kelu124/DAC2932/viewme.png

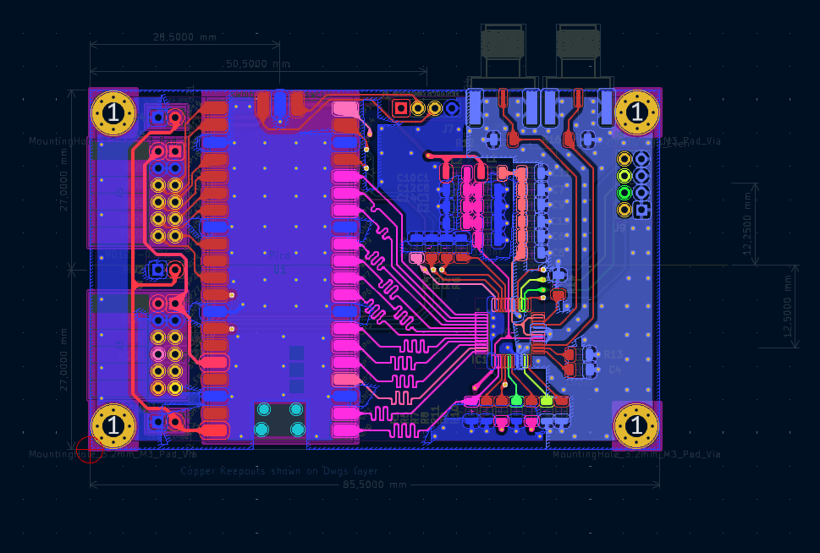
viewme.png
