kelu124/DAC2932/schematics.pdf

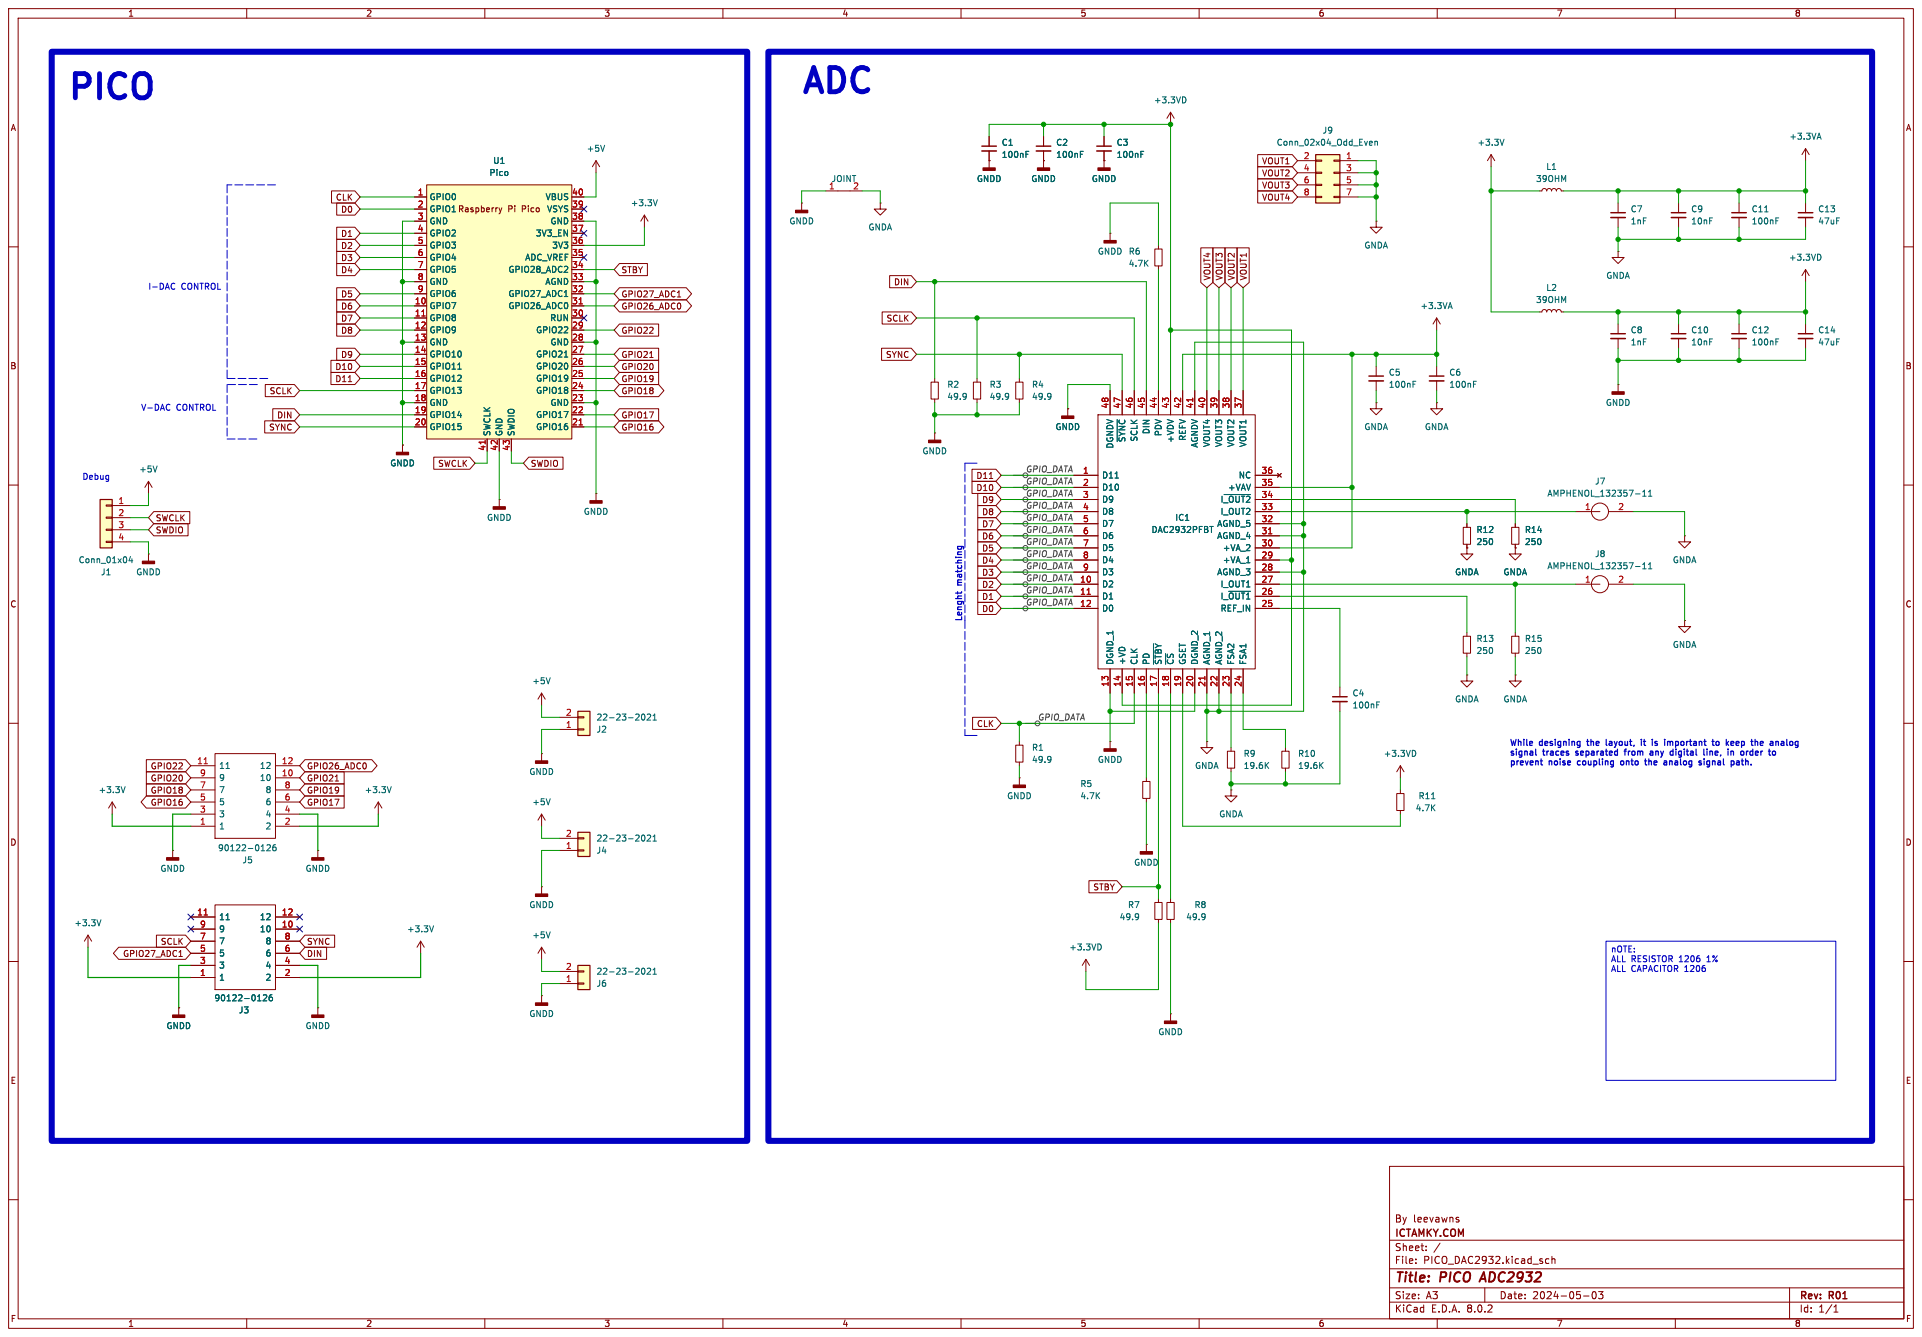
[picture p3: page 1]

I-DAC CONTROL V-DAC CONTROL PICO

While designing the layout, it is important to keep the analog
signal traces separated from any digital line, in order to
prevent noise coupling onto the analog signal path. nOTE: ALL RESISTOR 1206 1%
