kelu124/DAC2932/hardware/PICO_DAC2932.kicad_pcb

## KiCad design hardware/PICO_DAC2932.kicad_pcb (2024-09-25)

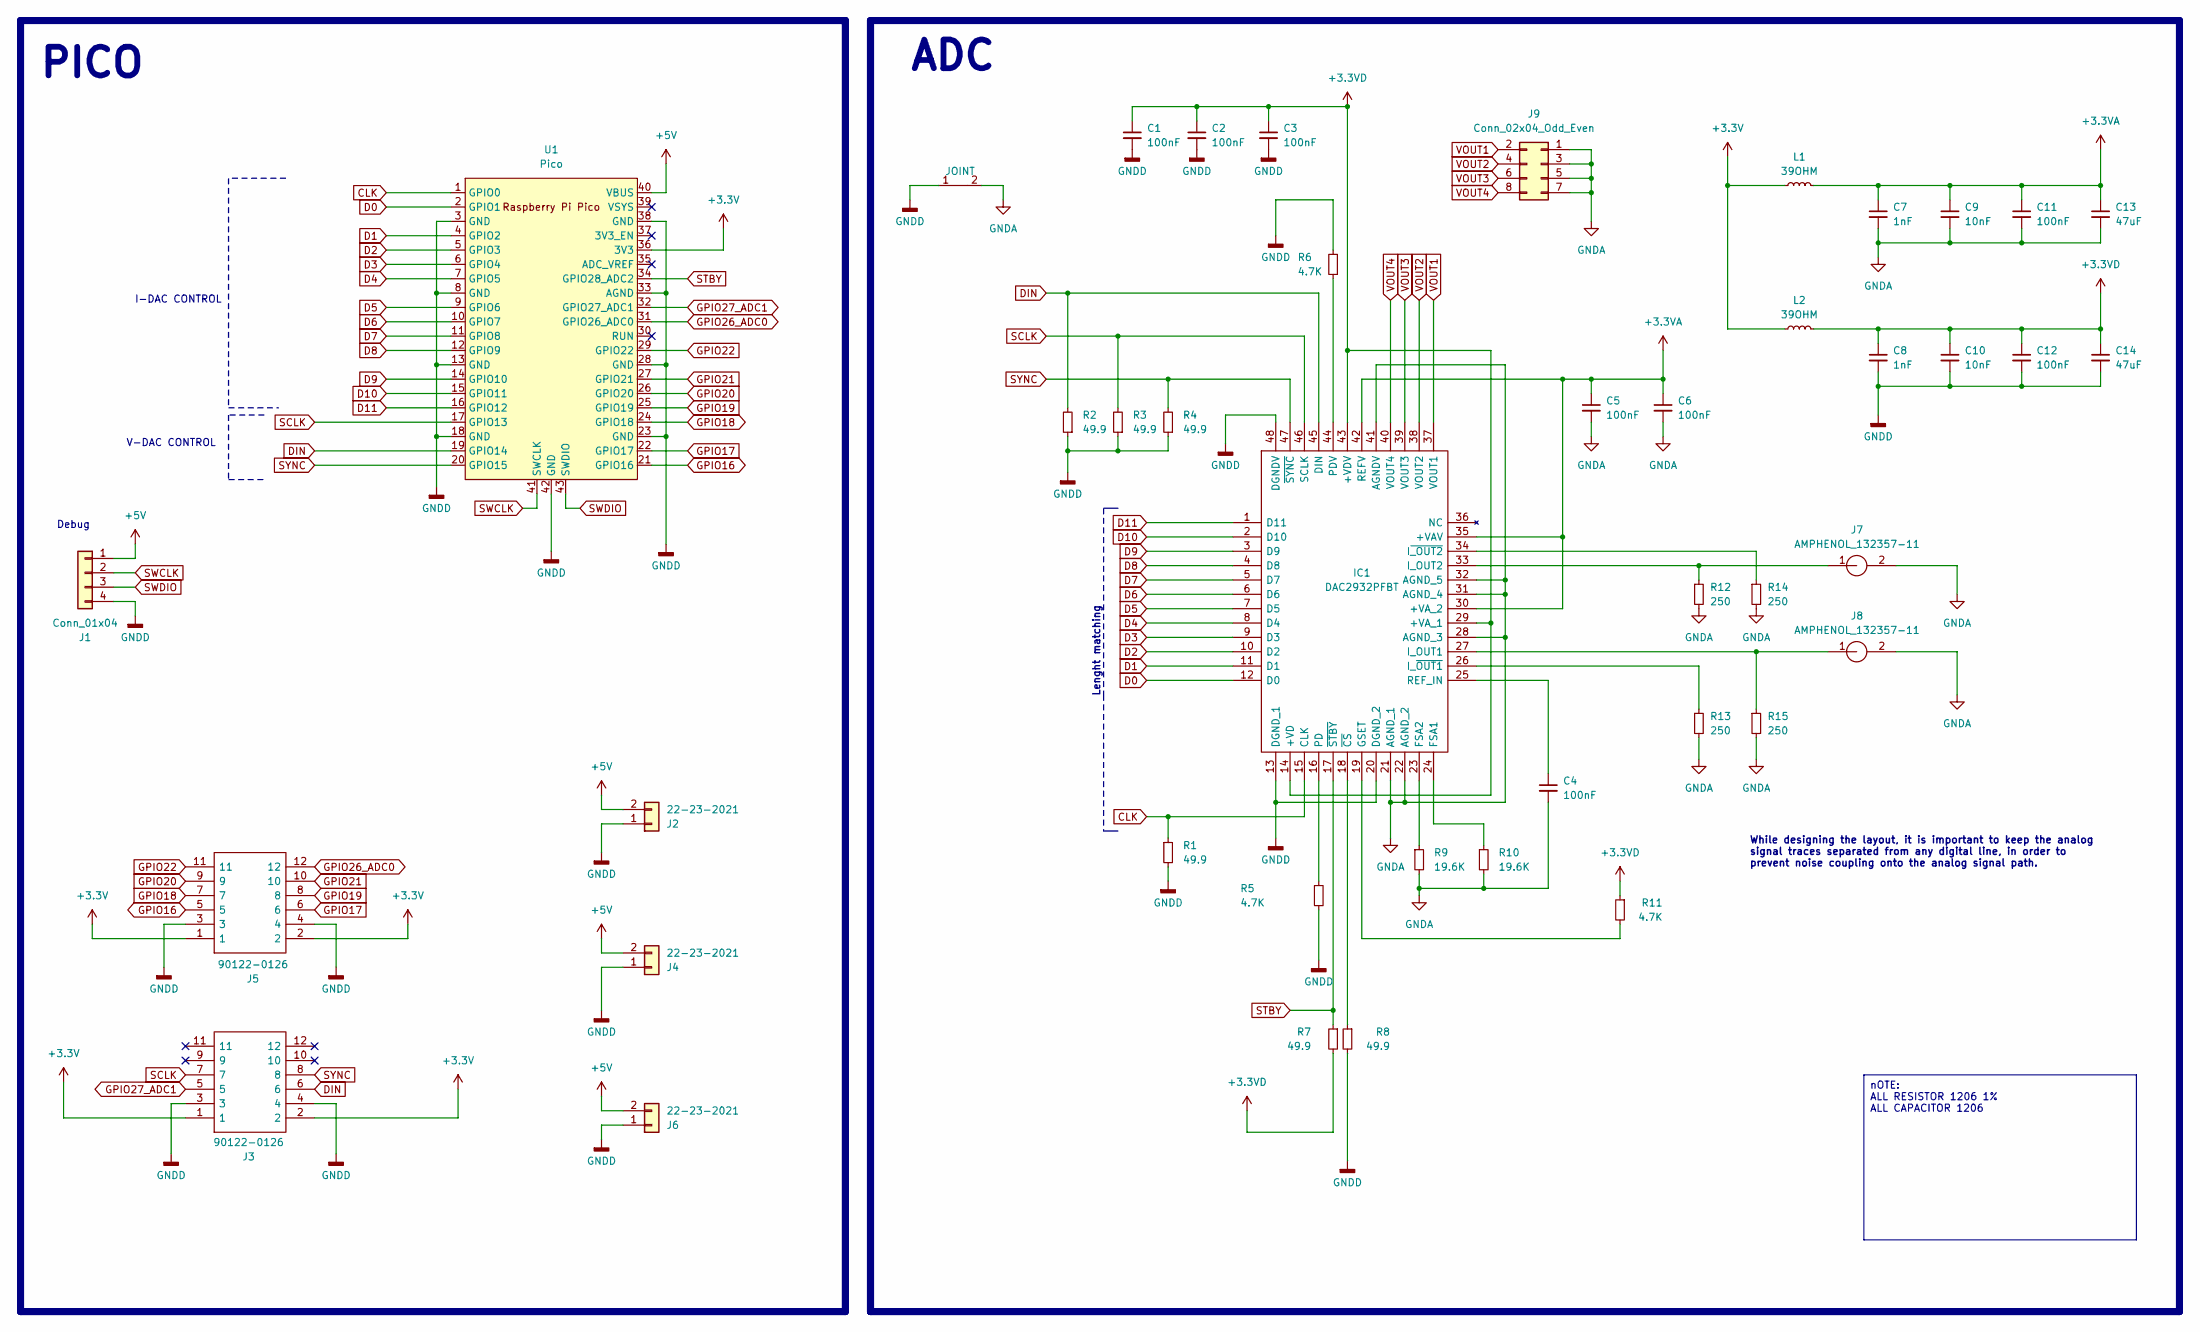
[picture p4: schematic PICO_DAC2932.kicad_sch, PICO ADC2932]

Parts:
C1, C2, C3, C4, C5, C6, C11, C12: 100nF; C_1206_3216Metric
C7, C8: 1nF; C_1206_3216Metric
C9, C10: 10nF; C_1206_3216Metric
C13, C14: 47uF; C_1206_3216Metric
IC1: DAC2932PFBT; QFP50P900X900X120-48N; Mouser Part Number 595-DAC2932PFBT
J1: Conn_01x04; PinHeader_1x04_P2.54mm_Vertical
J2, J4, J6: 22-23-2021; PinHeader_1x02_P2.54mm_Vertical; MPN 22-23-2021
J3, J5: 90122-0126; PinSocket_2x06_P2.54mm_Horizontal; Mouser Part Number 710-613012243121
J7, J8: AMPHENOL_132357-11; Mouser Part Number 530-142-0701-801
J9: Conn_02x04_Odd_Even; PinHeader_2x04_P2.54mm_Vertical
JO1: JOINT
L1, L2: 39OHM; L_1206_3216Metric; Tolerance 1%
R1, R2, R3, R4, R7, R8: 49.9; R_1206_3216Metric; Tolerance 1%
R5, R6, R11: 4.7K; R_1206_3216Metric; Tolerance 1%
R9, R10: 19.6K; R_1206_3216Metric; Tolerance 1%
R12, R13, R14, R15: 250; R_1206_3216Metric; Tolerance 1%
U1: Pico; RPi_Pico_SMD; MPN Pico

Connections:
+3.3V: J3.1, J3.2, J5.1, J5.2, L1.1, L2.1, U1.36 (3V3)
+3.3VA: C5.1, C6.1, C7.1, C9.1, C11.1, C13.1, IC1.30 (+VA_2), IC1.35 (+VAV), IC1.42 (REFV), L1.2
+3.3VD: C1.1, C2.1, C3.1, C8.1, C10.1, C12.1, C14.1, IC1.14 (+VD), IC1.29 (+VA_1), IC1.43 (+VDV), L2.2, R7.2, R11.1
+5V: J1.1, J2.2, J4.2, J6.2, U1.40 (VBUS)
CLK: IC1.15 (CLK), R1.1, U1.1 (GPIO0)
D0: IC1.12 (D0), U1.2 (GPIO1)
D1: IC1.11 (D1), U1.4 (GPIO2)
D2: IC1.10 (D2), U1.5 (GPIO3)
D3: IC1.9 (D3), U1.6 (GPIO4)
D4: IC1.8 (D4), U1.7 (GPIO5)
D5: IC1.7 (D5), U1.9 (GPIO6)
D6: IC1.6 (D6), U1.10 (GPIO7)
D7: IC1.5 (D7), U1.11 (GPIO8)
D8: IC1.4 (D8), U1.12 (GPIO9)
D9: IC1.3 (D9), U1.14 (GPIO10)
D10: IC1.2 (D10), U1.15 (GPIO11)
D11: IC1.1 (D11), U1.16 (GPIO12)
DIN: IC1.45 (DIN), J3.6, R2.2, U1.19 (GPIO14)
GNDA: C4.2, C5.2, C6.2, C7.2, C9.2, C11.2, C13.2, IC1.21 (AGND_1), IC1.22 (AGND_2), IC1.28 (AGND_3), IC1.31 (AGND_4), IC1.32 (AGND_5), IC1.41 (AGNDV), J7.2, J8.2, J9.1, J9.3, J9.5, J9.7, JO1.2, R9.2, R10.2, R12.2, R13.2, R14.2, R15.2
GNDD: C1.2, C2.2, C3.2, C8.2, C10.2, C12.2, C14.2, IC1.13 (DGND_1), IC1.20 (DGND_2), IC1.48 (DGNDV), J1.4, J2.1, J3.3, J3.4, J4.1, J5.3, J5.4, J6.1, JO1.1, R1.2, R2.1, R3.1, R4.1, R5.2, R6.2, R8.2, U1.3 (GND), U1.8 (GND), U1.13 (GND), U1.18 (GND), U1.23 (GND), U1.28 (GND), U1.33 (AGND), U1.38 (GND), U1.42 (GND)
GPIO16: J5.5, U1.21 (GPIO16)
GPIO17: J5.6, U1.22 (GPIO17)
GPIO18: J5.7, U1.24 (GPIO18)
GPIO19: J5.8, U1.25 (GPIO19)
GPIO20: J5.9, U1.26 (GPIO20)
GPIO21: J5.10, U1.27 (GPIO21)
GPIO22: J5.11, U1.29 (GPIO22)
GPIO26_ADC0: J5.12, U1.31 (GPIO26_ADC0)
GPIO27_ADC1: J3.5, U1.32 (GPIO27_ADC1)
unnamed: IC1.24 (FSA1), R10.1
unnamed: IC1.23 (FSA2), R9.1
unnamed: IC1.19 (GSET), R11.2
unnamed: IC1.27 (I_OUT1), J8.1, R15.1
unnamed: IC1.33 (I_OUT2), J7.1, R12.1
unnamed: IC1.26 (I_~OUT1), R13.1
unnamed: IC1.34 (I~_OUT2), R14.1
unnamed: IC1.16 (PD), R5.1
unnamed: IC1.44 (PDV), R6.1
unnamed: C4.1, IC1.25 (REF_IN)
unnamed: IC1.18 (~CS), R8.1
SCLK: IC1.46 (SCLK), J3.7, R3.2, U1.17 (GPIO13)
STBY: IC1.17 (~STBY), R7.1, U1.34 (GPIO28_ADC2)
SWCLK: J1.2, U1.41 (SWCLK)
SWDIO: J1.3, U1.43 (SWDIO)
SYNC: IC1.47 (~SYNC), J3.8, R4.2, U1.20 (GPIO15)
VOUT1: IC1.37 (VOUT1), J9.2
VOUT2: IC1.38 (VOUT2), J9.4
VOUT3: IC1.39 (VOUT3), J9.6
VOUT4: IC1.40 (VOUT4), J9.8

Notes on the sheet:
nOTE: ALL RESISTOR 1206 1% ALL CAPACITOR 1206
While designing the layout, it is important to keep the analog signal traces separated from any digital line, in order to prevent noise coupling onto the analog signal path.
ADC
Lenght matching
V-DAC CONTROL
PICO
Debug
I-DAC CONTROL

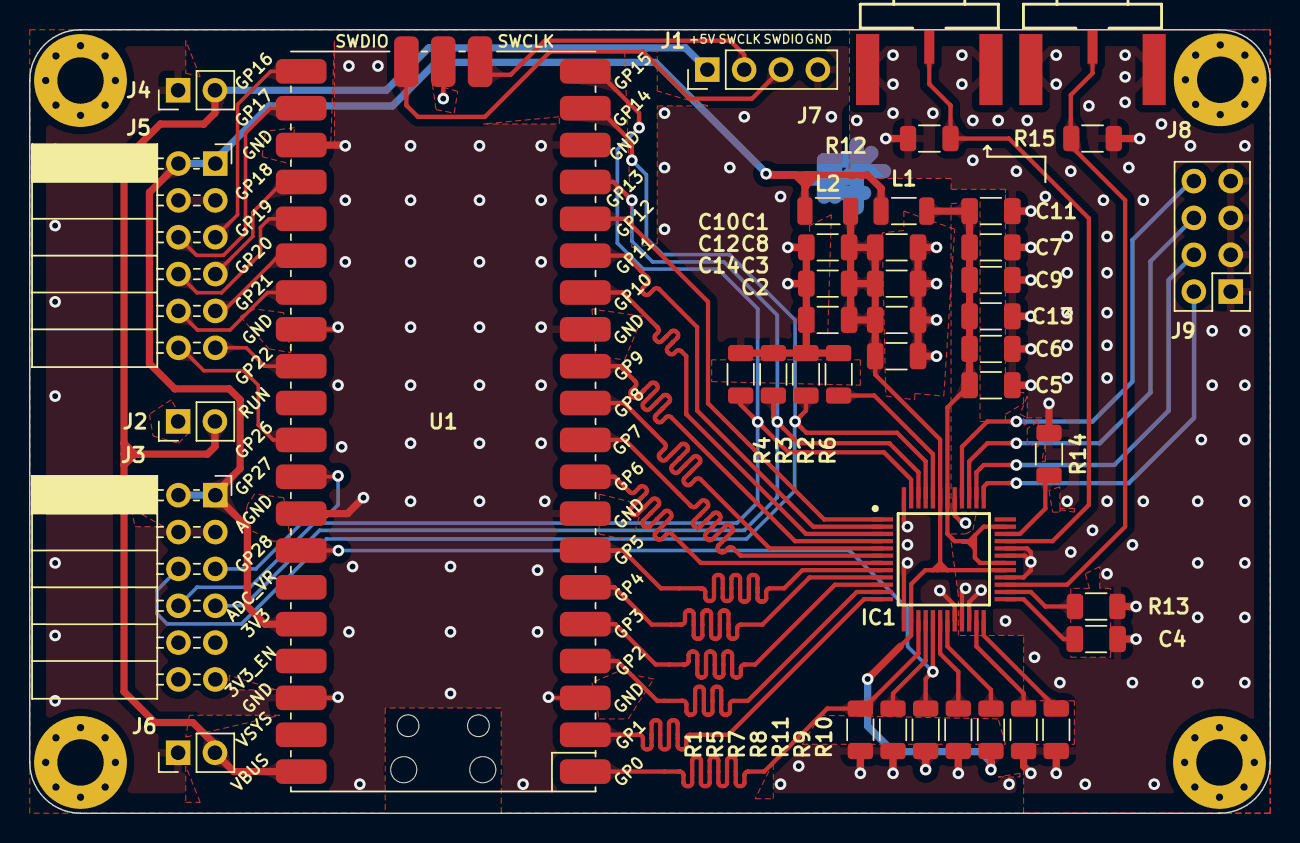
[picture p5: board PICO_DAC2932.kicad_pcb from above]

Board: 2 copper layers, 85.5 x 54.0 mm, 43 parts (1 on the bottom side), 49 nets.
