kelu124/DAC2932/software/vdac/vdac.h

//!
//! \file       vdac.h 
//! \date       2024-09-24
//!
//! \brief      vdac spi bit banging.
//!

#ifndef VDAC_H
#define VDAC_H

//---------------------------------------------------------------------------
// INCLUDES
//---------------------------------------------------------------------------

#include <stdio.h>
#include <stdlib.h>
#include "pico/stdlib.h"
#include "hardware/gpio.h"
#include "hardware/clocks.h"
#include "pico/multicore.h"

//---------------------------------------------------------------------------
// CONSTANTS
//---------------------------------------------------------------------------

#define PIN_SCLK 13
#define PIN_DIN 14
#define PIN_SYNC 15

//---------------------------------------------------------------------------
// DAC INIT FUNCTION
//---------------------------------------------------------------------------
void vdac_init();

//---------------------------------------------------------------------------
// DAC SPI WRITE FUNCTION
//---------------------------------------------------------------------------
void vdac_spi_write(uint16_t data);

//---------------------------------------------------------------------------
// DAC CALIBERATION
//---------------------------------------------------------------------------
void vdac_generate_calibration_signals();

//---------------------------------------------------------------------------
// DAC WRITE FUNCTION
//---------------------------------------------------------------------------
void vdac_write();

//---------------------------------------------------------------------------
// GPIO delays
//---------------------------------------------------------------------------
void delay_250ns();

//---------------------------------------------------------------------------
// DAC MAIN FUNCTION
//---------------------------------------------------------------------------
void vdac();

//---------------------------------------------------------------------------
// END OF FILE
//---------------------------------------------------------------------------

#endif
